scientistnobee/Pocket-Spectrometer-V2/3D Design Files/V3_Colorimeter/FreeCAD/Colorimeter_Cover.FCStd

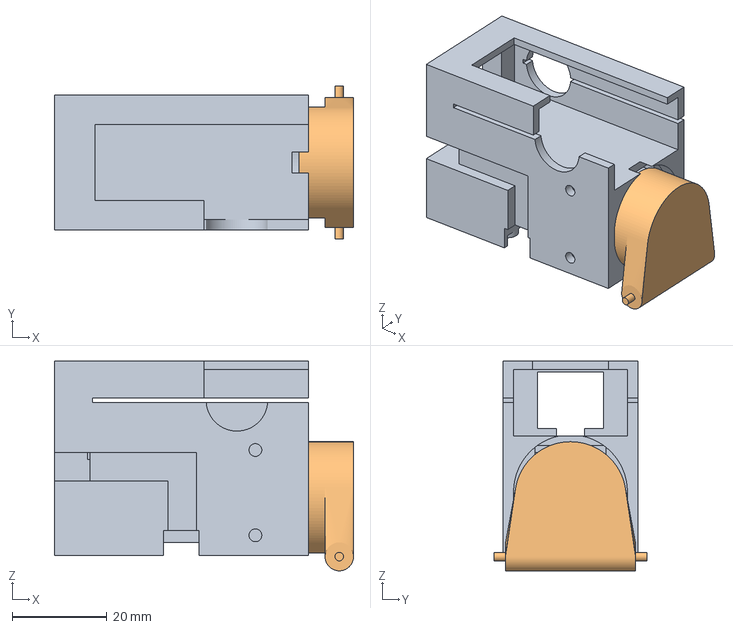
[picture p1: CAD file, 2026-10-23]
3D Design Files/V3_Colorimeter/FreeCAD/Colorimeter_Cover.FCStd
63.1 x 32.3 x 44.2 mm
Base6_scad
Lid_v14_scad
