scientistnobee/Pocket-Spectrometer-V2/3D Design Files/V3_Colorimeter/STLs/m5stick_colorometer_ada_cover_v14_cover.stl

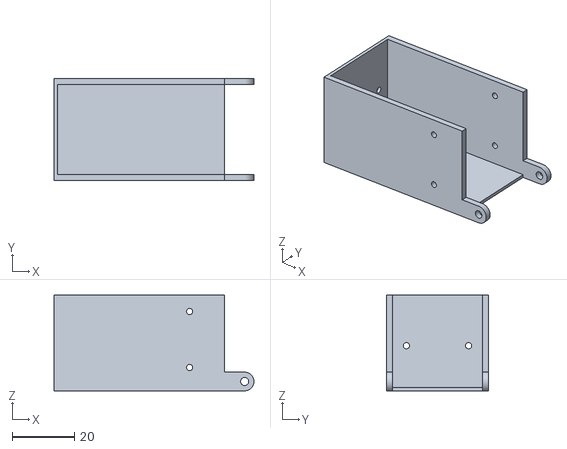
[picture p2: CAD file, 2026-10-23]
3D Design Files/V3_Colorimeter/STLs/m5stick_colorometer_ada_cover_v14_cover.stl
64.3 x 32.9 x 30.8
