scientistnobee/Pocket-Spectrometer-V2/3D Design Files/V3_Colorimeter/FreeCAD/m5spectrometer_cuvette.FCStd

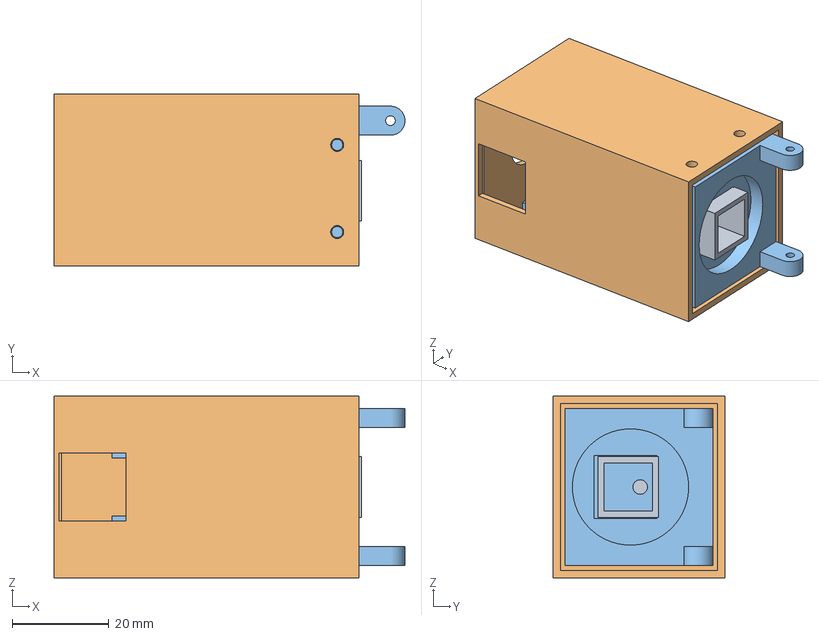
[picture p3: CAD file, 2026-10-23]
3D Design Files/V3_Colorimeter/FreeCAD/m5spectrometer_cuvette.FCStd
72.5 x 35.5 x 37.5 mm
Cuvette
Enclosure_Sleeve
m5stick_colorometer_iorodeo2_atom7_lid
