scientistnobee/Pocket-Spectrometer-V2/3D Design Files/V3_Colorimeter/STLs/m5stick_colorometer_ada_cover_v14_lid.stl

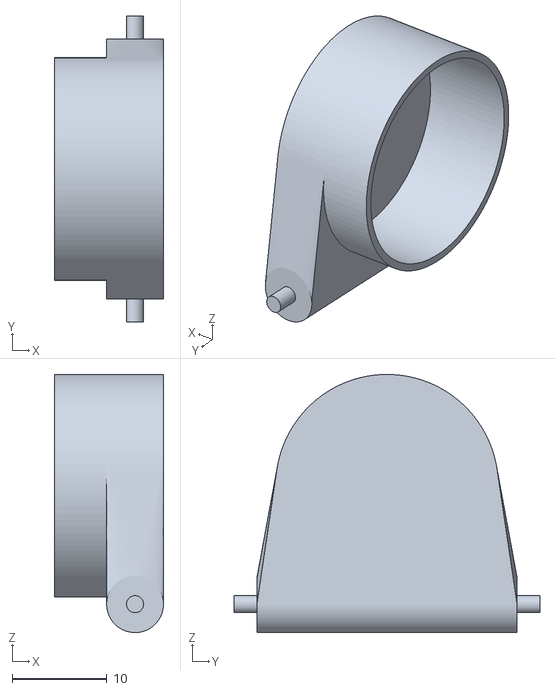
[picture p4: CAD file, 2026-10-23]
3D Design Files/V3_Colorimeter/STLs/m5stick_colorometer_ada_cover_v14_lid.stl
11.5 x 32.3 x 27.2
