scientistnobee/Pocket-Spectrometer-V2/3D Design Files/V3_Colorimeter/STLs/m5stick_colorometer_ada_base6.stl

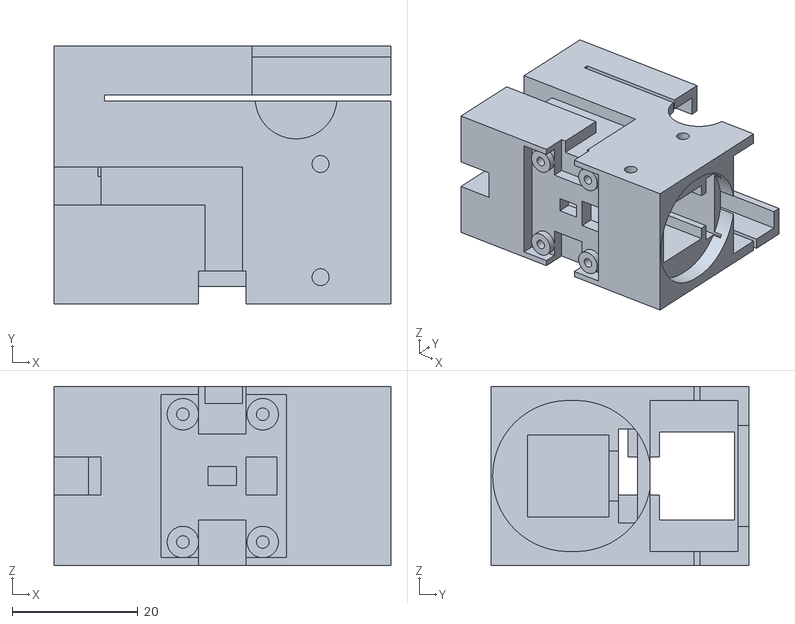
[picture p5: CAD file, 2026-10-23]
3D Design Files/V3_Colorimeter/STLs/m5stick_colorometer_ada_base6.stl
53.6 x 41.0 x 28.5
