scientistnobee/Pocket-Spectrometer-V2/3D Design Files/V3_Colorimeter/STLs/Enclosure_Sleeve.stl

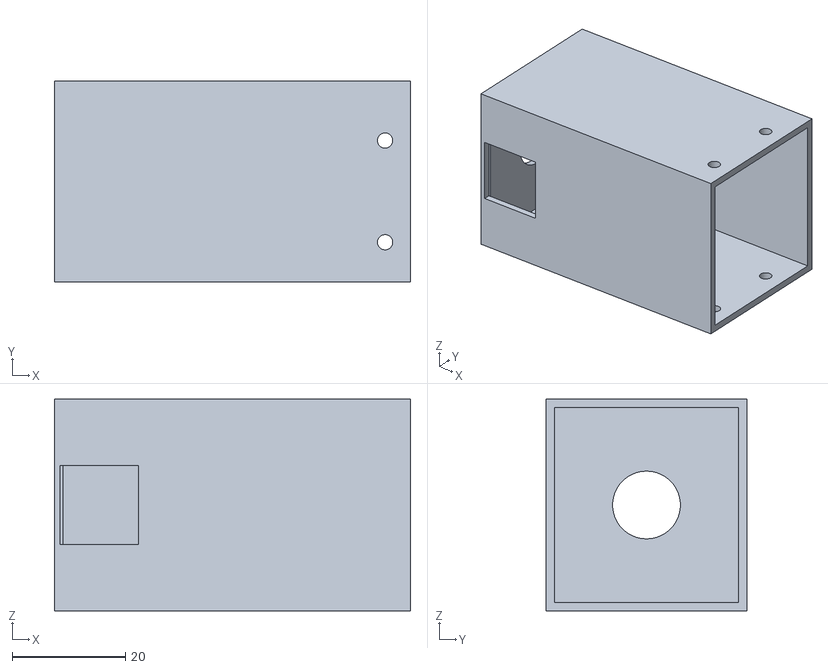
[picture p7: CAD file, 2026-10-23]
3D Design Files/V3_Colorimeter/STLs/Enclosure_Sleeve.stl
63.0 x 35.5 x 37.5
