scientistnobee/Pocket-Spectrometer-V2/3D Design Files/V3_Colorimeter/STLs/m5stick_colorometer_ada_cover_v13_lid.stl

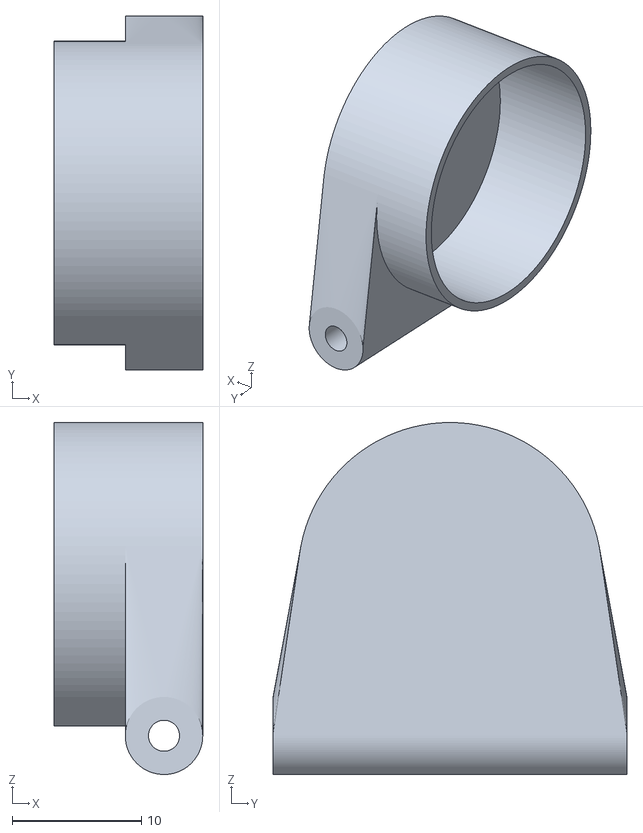
[picture p8: CAD file, 2026-10-23, an earlier design]
3D Design Files/V3_Colorimeter/STLs/m5stick_colorometer_ada_cover_v13_lid.stl
11.5 x 27.4 x 27.2
