scientistnobee/Pocket-Spectrometer-V2/3D Design Files/V3_Colorimeter/OpenScad/m5stick_colorometer_ada_base6.scad

//color([0,0,1])
//translate([8.4,-24,12]) 
// rotate([90,90,180])
//import("AS7341.stl", convexity=3);


height_pd1=12;
height_pd=12;

cap_stretch=1.2; // recess stretch for the hinged lid (see cover v12)
Screwdia=3.4;
Screwdia2=3.4;
hole_d=2.7; // screw hole dia, matches Enclosure_Sleeve (M2.5)
ada_screw=2.0; // AS7341 board mounting screw (from lid_only version)
 
$fn = 100; 
 w_m5=26.0;// width of m5stick
 h_m5=48.6;// length of m5stick pocket: M5StickC Plus is 48.1 + 0.5 tol (was 45)
 dx=h_m5-45; // growth of the pocket; the -X end stays put, the +X end moves out by dx
 t_m5=16; // thickness of m5stick
 wall=1.5; //wall of the body
 tol=0.5; //tolerance for printing
 //color([1,1,1], 0.5)
 module spectrometer () {
 difference(){
 union() {

     
      translate([dx/2,0,0]) 
     cube ([h_m5,w_m5+tol+3,w_m5+tol+2], center=true);  //cuvette holder
     
           translate([-5+dx/2,0,0]) 
     cube ([h_m5,w_m5+tol+3,w_m5+tol+2], center=true);  // extra cuvette holder bottom
     
     
       translate([dx/2,18,0]) 
       cube ([h_m5, t_m5+tol, w_m5+tol+2], center=true);
     
            translate([-5+dx/2,18,0]) 
       cube ([h_m5, t_m5+tol, w_m5+tol+2], center=true); //extra bottom part
     
 
   
 }
 union() {
      
    translate([-3.1, -2.5, 2])    rotate([90, 0, 0]) 
       enclosure_screws1(); 
 buttons_gap();     
          translate([21.0+dx,-2.5,0])
     rotate([0,90,0])
     hull(){ // recess stretched toward the top (+Y here, +Z in the cover frame) so the hinged lid can swing out
       cylinder(d=24, h=4, center=true);
       translate([0,cap_stretch,0]) cylinder(d=24, h=4, center=true);
     }// space for cap
     
  translate([-10,-13,-6.5])
rotate([90,0,0])
ada();   //space for AMS spectral sensor
     
           translate([-24.0,4,8]) 
            cube ([8, 6, 13], center=true);// for wiring4
    
             translate([-14.0,4,13]) 
            cube ([22, 6, 3], center=true);// for wiring3

      
                  translate([-0.5,-14,10]) 
            cube ([6, 6, 3], center=true);// for wiring3c
     
            translate([-0.5,-4,13]) 
            cube ([6, 22, 3], center=true);// for wiring2
     
           translate([-24.0,4,0]) 
            cube ([8, 40, 6], center=true);// for wiring1 bottom
     
     translate([4+dx/2,-2.5,0]) 
          cube ([h_m5+tol,13.0,13.0], center=true); //cuvette
            color([1,0,0.5])
        translate([0.5+dx/2,17.5,0]) 
            cube ([ h_m5, t_m5-wall-0.5, w_m5-wall-0.5], center=true);//m5stickc
            
translate([11.0,18,13]) 
cube ([8, 9, 3], center=true);// for m5 buttonB

 
 
 translate([-12,18,-13]) 
cube ([8, 9, 3], center=true);// for m5 buttonC
 
 
  translate([3+dx/2,18,-13]) 
cube ([h_m5, 1, 3], center=true);// for m5 slit1


translate([3+dx/2,18,13]) 
cube ([h_m5, 1, 3], center=true);// for m5 slit2
 
               color([0.5,0,0.5])
        translate([-20,18,0]) 
           cube ([20,12,14], center=true); 
     
        translate([3+dx/2,28,0]) 
           cube([44+dx,10,16], center=true);//oled screen
     
             translate([2,7,0]) 
     cube ([45,3,15], center=true);  //optical_filter
     
     
             translate([5,3,0]) 
           cube([40,8,8], center=true);//optical sensor window 
           
 
            

   
 }
 }
}

module buttons(){
 translate([-12,24,-12]) 
cube ([13, 13, 8], center=true);// button for m5 buttonC
 
 
 translate([14,24,13.15]) 
cube ([20, 13, 8], center=true);// for m5 buttonB
}


module buttons_gap(){
 translate([-12,18.0,-15]) 
cylinder(d=13, h=10);// button for m5 buttonC
 
 
 translate([11.0,18,7]) 
cylinder(d=13, h=10);// for m5 buttonB
    
    
     translate([15.5,24,11]) 
cube ([23, 13, 8], center=true);// for m5 buttonB; runs out through the +X end face (X 4..27) so no floating wall piece is left at X 24..26.1
}






 module cap(){
difference(){
 union() {
 rotate([0,90,0])
         translate([0,0,0])
     cylinder(d=23.5, h=12, center=true);
     
 }

 union() {
              translate([-0.1,0.0,0.0])
 rotate([0,90,0])

     cylinder(d=20, h=12, center=true);
     }
 
 }
 }
 
//translate([30,-3,0])
//cap();
 
  //translate([-10,-12,-7])
//rotate([90,0,0])
//ams2();
 
 //buttons();
  
module ada(){
color([1,0,0])
union(){
    translate([-0.5,-6.5,-1.0])
cube ([20.0,26.0,4.0]);  // PCB


    color([0.4,0.6,0.1])
translate([3,-4.0,-7.0])
union(){
translate([0,0,0])
cylinder(d=ada_screw, h=10);//screw hole1

translate([12.7,0,0])
cylinder(d=ada_screw, h=10);//screw hole2
    
translate([0,20.32,0])
cylinder(d=ada_screw, h=10);//screw hole3

translate([12.7,20.32,0])
cylinder(d=ada_screw, h=10);//screw hole4   
    
}    


color([0.4,0.6,0.5])

translate([0,5.5,-4.5])
union(){
    
    translate([7.0,-0.5,-2])
cube ([4.5,3,10]); //Ams sensor

    translate([13.0,-2,-2])    
cube ([5,6,10]); //LED
    
    
    
    translate([5.5,7.7,1])    
cube ([7.5,10,7]); //Connector1 space    
    
    
     translate([5.5,-16.0,1])    
cube ([7.5,10,7]); //Connector2 space     
  

    
}
}
}


 module enclosure_screws1(){    
rotate([90,0,0])
translate([18,8,-20])
cylinder(d=hole_d, h=10);// Side screw1
 
 
rotate([90,0,0])
translate([18,8,14])
cylinder(d=hole_d, h=10);// Side screw2
 
rotate([0,90,0])
translate([-1,8,-30])
cylinder(d=hole_d, h=10);// Bottom screw1
 

rotate([0,90,0])
translate([-1,-12,-30])
cylinder(d=hole_d, h=10);// Bottom screw2
     
rotate([90,0,0])
translate([18,-10,-20])
cylinder(d=hole_d, h=10);// Side screw3
 
 
 rotate([90,0,0])
translate([18,-10,14])
cylinder(d=hole_d, h=10);// Side screw4    



 }

spectrometer ();

// pillars around the AS7341 board screw holes (same placement as iorodeo2_atom7_lid)
translate([-10,-10.5,-6.5])
rotate([90,0,0])
ada_stubs();

module ada_stubs(){
    difference (){
       color([0.4,0.6,0.1])
translate([3,-4.0,-7.0])
union(){ 
    translate([0,0,0])
cylinder(d=ada_screw*2.5, h=10);//screw hole1

translate([12.7,0,0])
cylinder(d=ada_screw*2.5, h=10);//screw hole2
    
translate([0,20.32,0])
cylinder(d=ada_screw*2.5, h=10);//screw hole3

translate([12.7,20.32,0])
cylinder(d=ada_screw*2.5, h=10);//screw hole4   
}
    color([0.4,0.6,0.1])
translate([3,-4.0,-6.0])
union(){
translate([0,0,0])
cylinder(d=ada_screw, h=10);//screw hole1

translate([12.7,0,0])
cylinder(d=ada_screw, h=10);//screw hole2
    
translate([0,20.32,0])
cylinder(d=ada_screw, h=10);//screw hole3

translate([12.7,20.32,0])
cylinder(d=ada_screw, h=10);//screw hole4   
    
}
    }
}
