scientistnobee/Pocket-Spectrometer-V2/(list of files, cad)

Other CAD files:
3D Design Files/V3_Colorimeter/STLs/m5stick_colorometer_ada_cover_v13_cover.stl
3D Design Files/V3_Colorimeter/OpenScad/m5stick_colorometer_ada_cover_v13.scad
