scientistnobee/Pocket-Spectrometer-V2/(commit log)

2026-03-22 update device UI to prortrait mode with legible font size
2026-03-22 m5 atom board spectrometer
2026-03-22 update: - support for m5 stcikc plus 2 device - testing files added - docs updated.
2026-03-22 fix: resolve AS7341 sensor detection failure on M5StickC Plus 2
    M5.begin() leaves the Wire bus in an unclean state on Plus 2, preventing
    the AS7341 from being detected (showing "SENSOR ERROR!"). Fix by calling
    Wire.end() before Wire.begin() and setting explicit 100kHz clock speed.
    Grove PORT A pins are GPIO32 (SDA) / GPIO33 (SCL) on both Plus and Plus 2
    — confirmed from official M5Stack UserDemo source. Previous docs incorrectly
    listed GPIO0/26 for Plus 2.
    Verified working: all 9 spectral channels (415–940nm) reading correctly
    after fix, flashed to device at /dev/cu.usbserial-5A370206391.
2026-10-23 add V3 colorimeter enclosure (base6, cover v13, sleeve)
    Base screw holes set to O2.7 to match the Enclosure_Sleeve.
2026-10-23 add cover v14 with print-in-place pin hinge
